ksychla/BadUSB/resources/img/schema.png

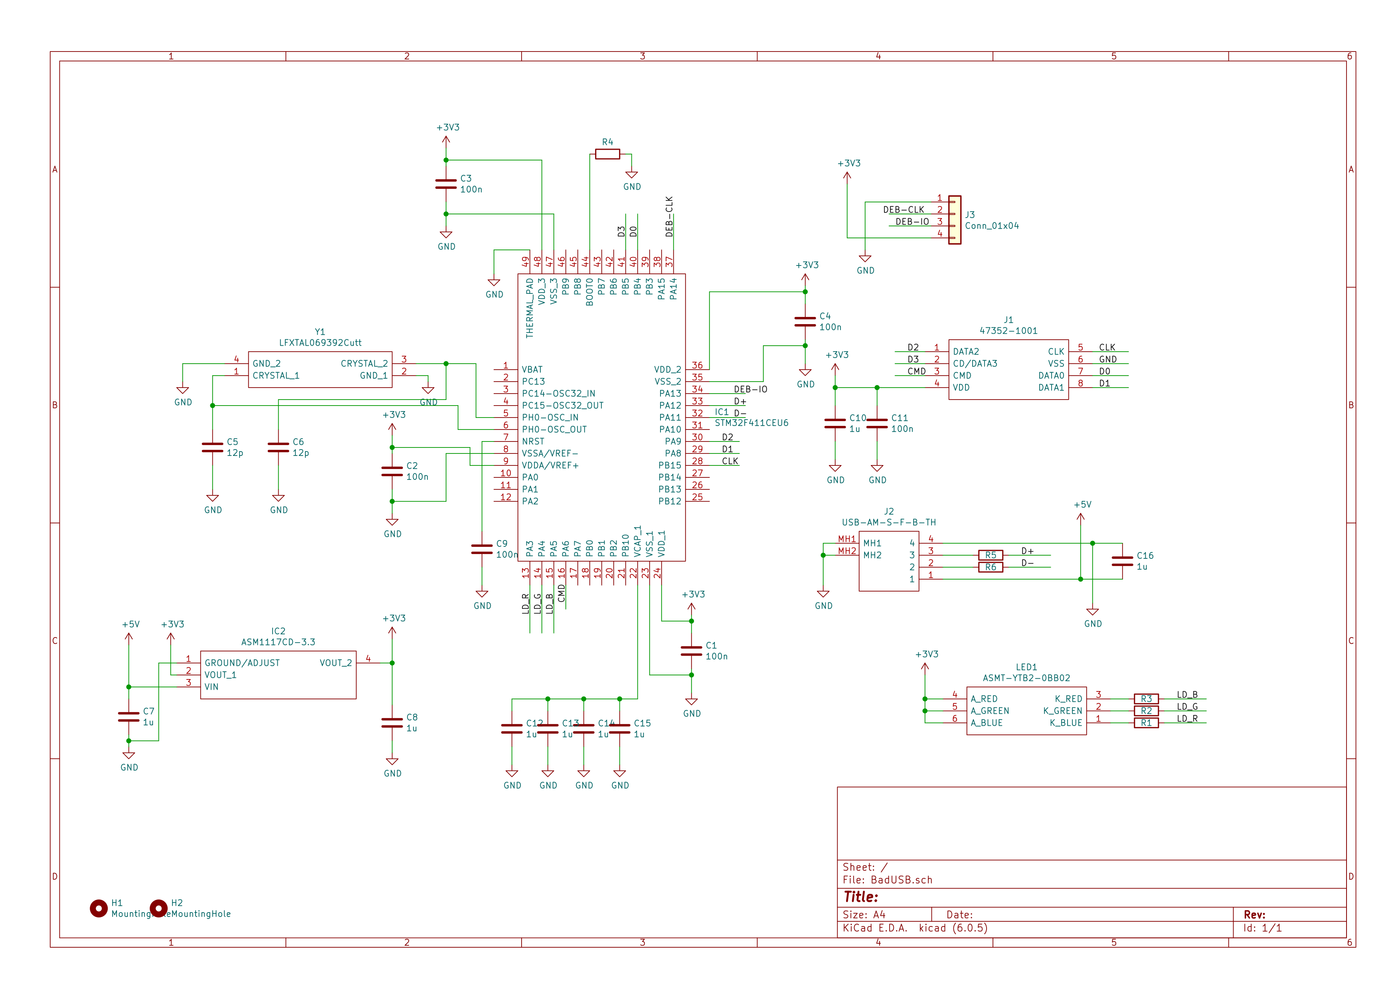
resources/img/schema.png
