ksychla/BadUSB/resources/kicad/BadUSB.pdf

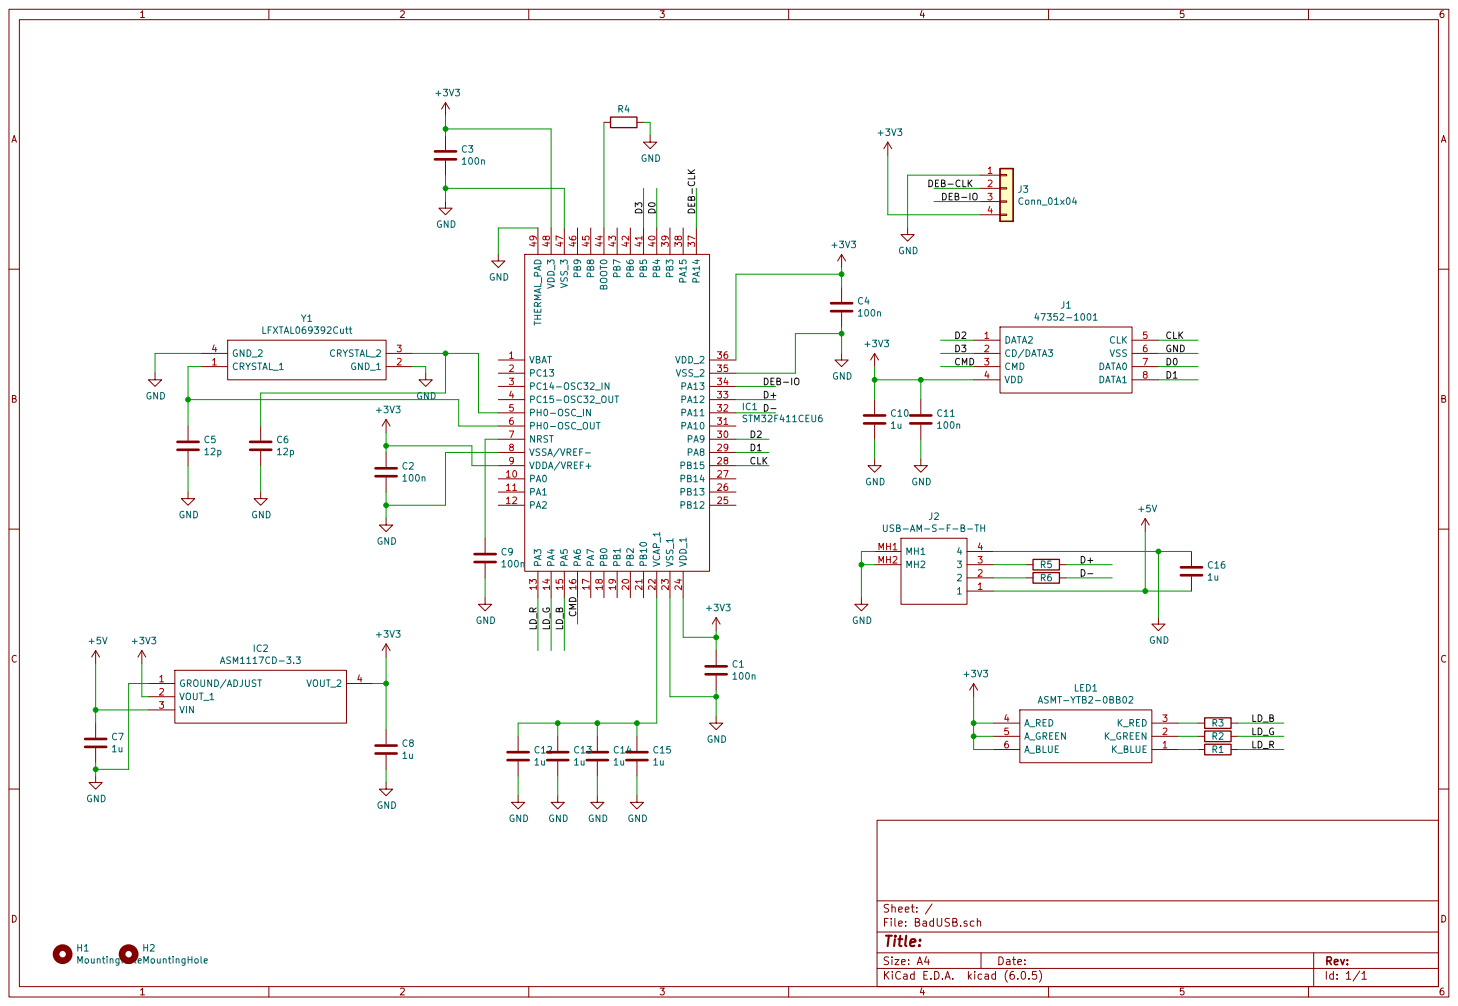
[picture p2: page 1]

Id: 1/1 Title: File: BadUSB.sch Sheet: /
