ksychla/BadUSB/resources/kicad/BadUSB.kicad_pcb

## KiCad design resources/kicad/BadUSB.kicad_pcb (2022-05-14)

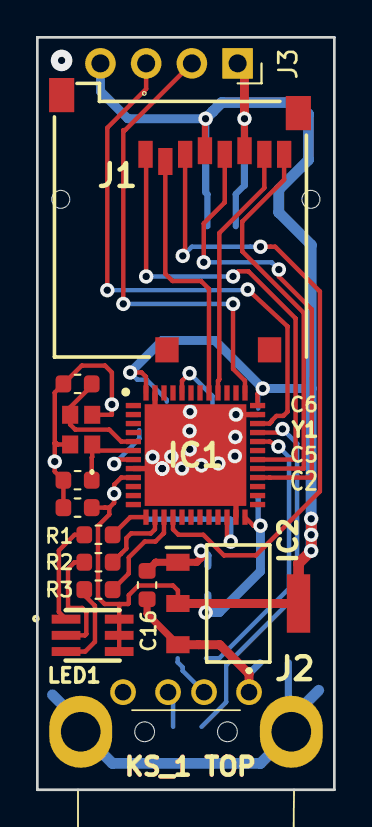
[picture p3: board BadUSB.kicad_pcb from above]

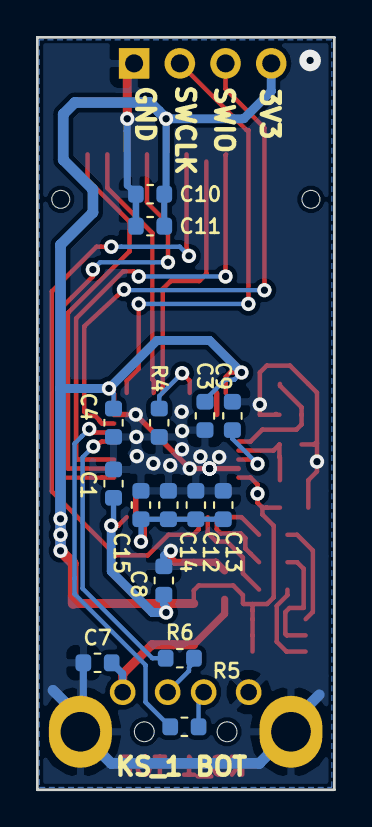
[picture p4: board BadUSB.kicad_pcb from below]

Board: 2 copper layers, 16.5 x 41.8 mm, 31 parts (15 on the bottom side), 26 nets.

Parts:
C1, C2, C3, C4, C9, C11: 100n; C_0603_1608Metric
C5, C6: 12p; C_0603_1608Metric
C7, C8, C10, C12, C13, C14, C15, C16: 1u; C_0603_1608Metric
H1, H2: MountingHole; MountingHole_2.2mm_M2
IC1: STM32F411CEU6; QFN50P700X700X60-49N-D
IC2: ASM1117CD-3.3; SOT229P700X180-4N
J1: 47352-1001
J2: USB-AM-S-F-B-TH; USBAMSFBTH
J3: Conn_01x04; PinSocket_1x04_P2.54mm_Horizontal
LED1: ASMT-YTB2-0BB02; ASMT-YTC7-0AA02
R1: 470R; R_0603_1608Metric
R2, R3, R5, R6: R; R_0603_1608Metric
R4: 10k; R_0603_1608Metric
Y1: LFXTAL069392Cutt

Connections:
+3V3: C1.1, C2.1, C3.1, C4.1, C8.1, C10.1, C11.1, IC1.9, IC1.24, IC1.36, IC1.48, IC2.2, IC2.4, J1.4, J3.4, LED1.4, LED1.5, LED1.6
+5V: C7.1, C16.2, IC2.3, J2.1
/CLK: IC1.28, J1.5
/CMD: IC1.16, J1.3
/D0: IC1.40, J1.7
/D1: IC1.29, J1.8
/D2: IC1.30, J1.1
/D3: IC1.41, J1.2
/D+: IC1.33, R5.1
/D-: IC1.32, R6.1
/DEB-CLK: IC1.37, J3.2
/DEB-IO: IC1.34, J3.3
/LD_B: IC1.15, R3.1
/LD_G: IC1.14, R2.1
/LD_R: IC1.13, R1.1
GND: C1.2, C2.2, C3.2, C4.2, C5.2, C6.2, C7.2, C8.2, C9.2, C10.2, C11.2, C12.2, C13.2, C14.2, C15.2, C16.1, IC1.8, IC1.23, IC1.35, IC1.47, IC1.49, IC2.1, J1.6, J2.4, J2.MH1, J2.MH2, J3.1, R4.1, Y1.2, Y1.4
unnamed: C5.1, IC1.6, Y1.1
unnamed: C6.1, IC1.5, Y1.3
unnamed: C9.1, IC1.7
unnamed: C12.1, C13.1, C14.1, C15.1, IC1.22
unnamed: IC1.44, R4.2
unnamed: J2.2, R6.2
unnamed: J2.3, R5.2
unnamed: LED1.1, R1.2
unnamed: LED1.2, R2.2
unnamed: LED1.3, R3.2
