ksychla/BadUSB/(commit log)

2022-05-14 Add kicad project
    [BadUSB.kicad_pcb, BadUSB.sch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]
2022-05-31 Working keyboard interface
    [BadUSB.sch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]
2022-06-06 Add not working SDIO
    [fatfs.c, file_handling.c, file_handling.h]
2022-06-12 Change clock config for final board
2022-08-30 Change LED functionality and Add final tests
